codr-shiv/amr/learning/iteration-phase/frames_2026-09-26_03.27.23.pdf

view_frames Result

Recorded at time: 1790373443.6042182

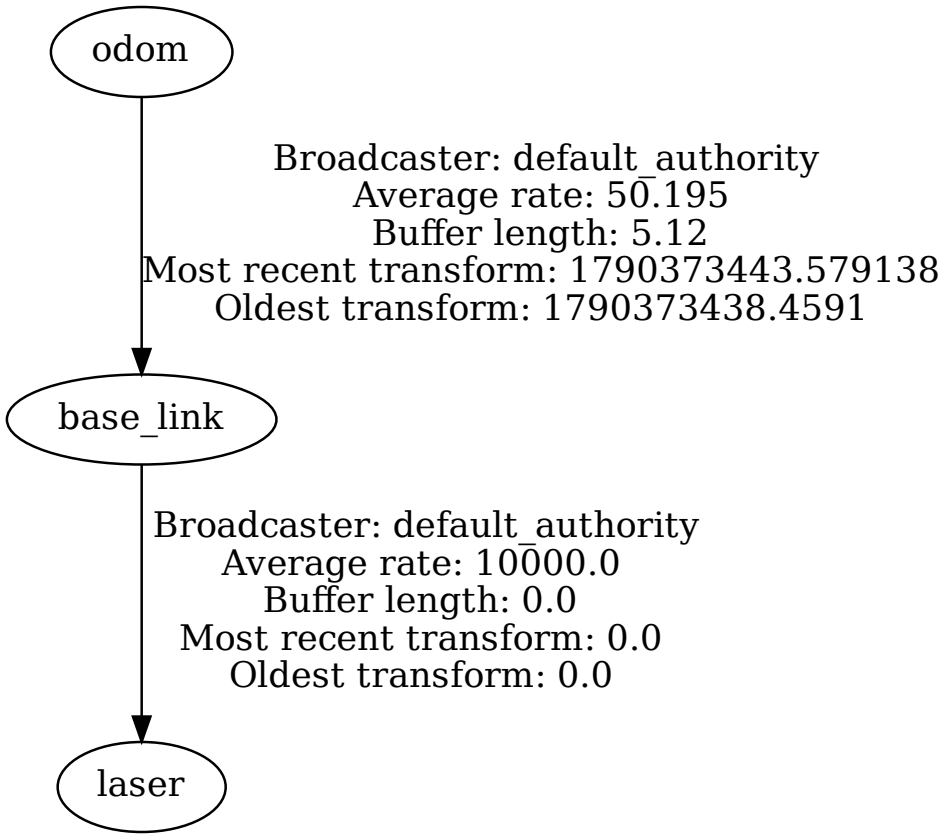
[picture p2: figure]
odom; base_link; Broadcaster: default_authority Average rate: 50.195 Buffer length: 5.12 Most recent transform: 1790373443.579138 Oldest transform: 1790373438.4591; laser; Broadcaster: default_authority Average rate: 10000.0 Buffer length: 0.0 Most recent transform: 0.0 Oldest transform: 0.0
