codr-shiv/amr/learning/iteration-phase/frames_2026-09-26_08.47.51.pdf

view_frames Result

Recorded at time: 1790392671.2278192

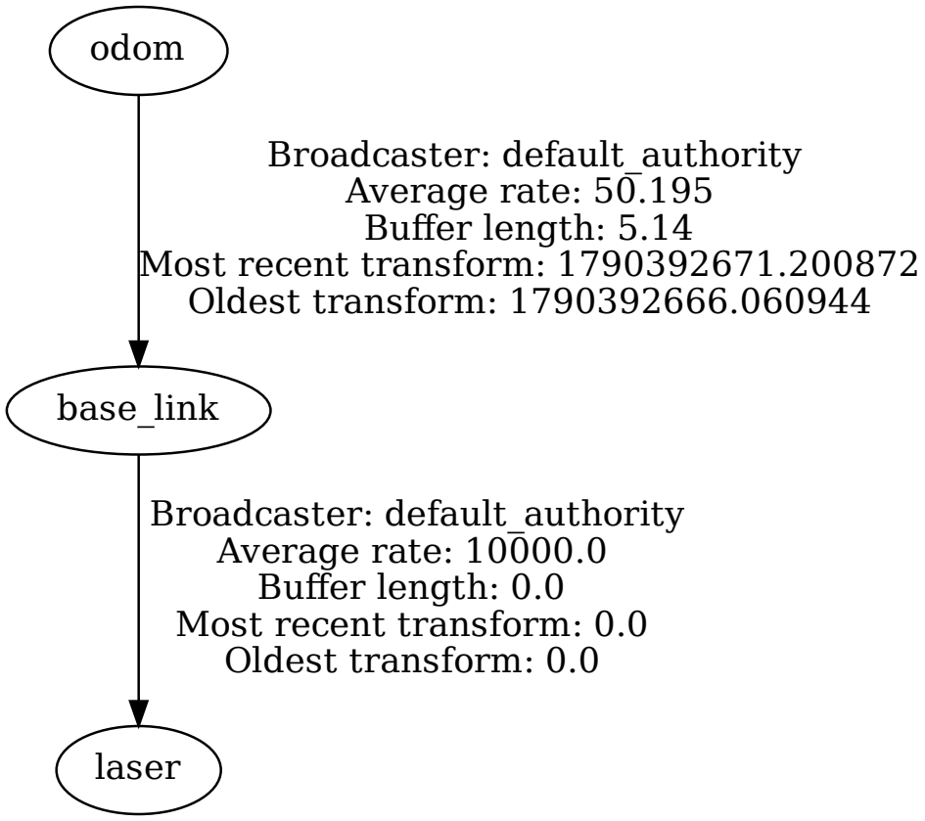
[picture p3: figure]
odom; base_link; Broadcaster: default_authority Average rate: 50.195 Buffer length: 5.14 Most recent transform: 1790392671.200872 Oldest transform: 1790392666.060944; laser; Broadcaster: default_authority Average rate: 10000.0 Buffer length: 0.0 Most recent transform: 0.0 Oldest transform: 0.0
