codr-shiv/amr/learning/iteration-phase/frames_2026-09-26_07.19.03.pdf

view_frames Result

Recorded at time: 1790387343.1438324

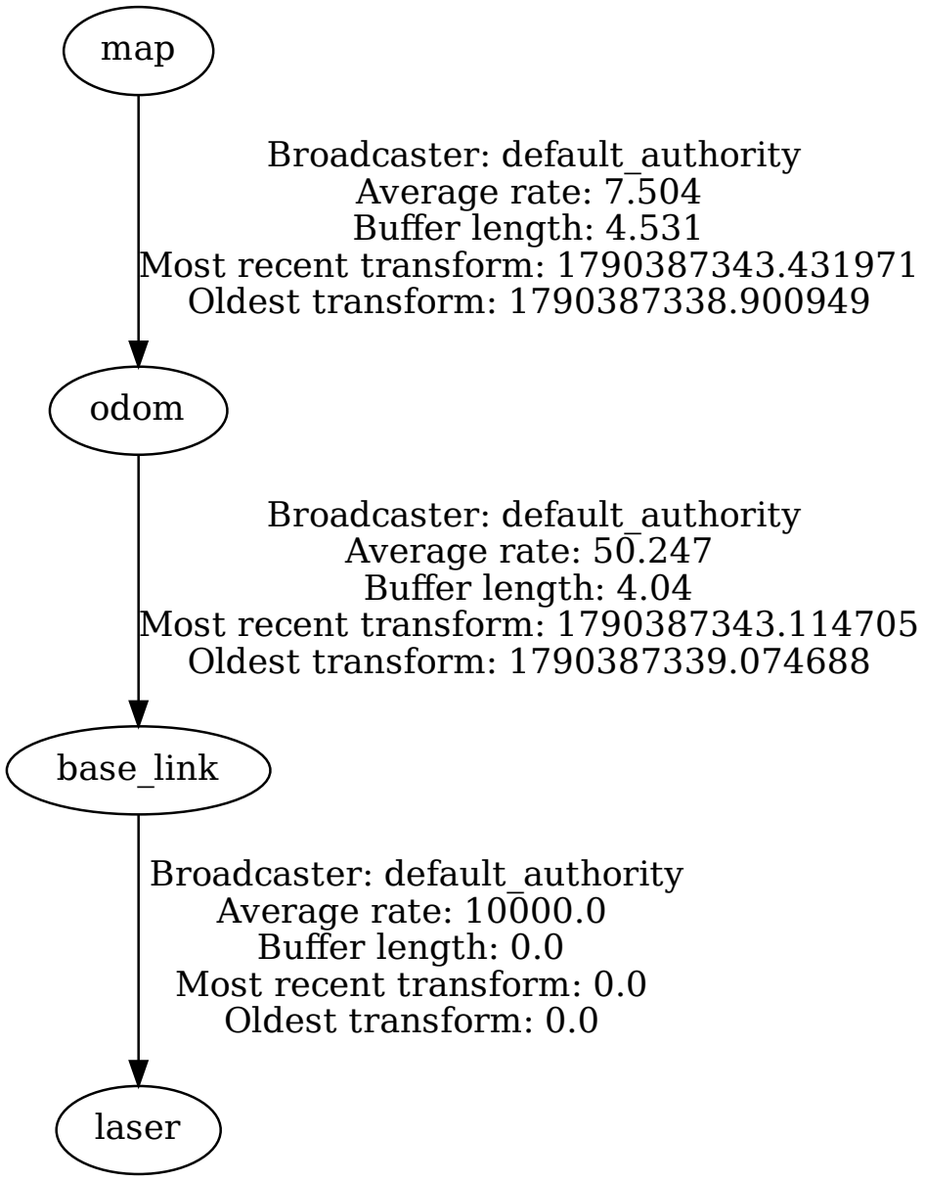
[picture p4: figure]
map; odom; Broadcaster: default_authority Average rate: 7.504 Buffer length: 4.531 Most recent transform: 1790387343.431971 Oldest transform: 1790387338.900949; base_link; Broadcaster: default_authority Average rate: 50.247 Buffer length: 4.04 Most recent transform: 1790387343.114705 Oldest transform: 1790387339.074688; laser; Broadcaster: default_authority Average rate: 10000.0 Buffer length: 0.0 Most recent transform: 0.0 Oldest transform: 0.0
