codr-shiv/amr/final-product/docs/guides/02-micro-ros-communication.md

# micro-ROS communication (ESP32 ⇄ Raspberry Pi)

How the ESP32 becomes part of the ROS 2 graph: transport, the agent, entities, QoS, message memory,
time synchronization, reconnection, and how to debug it.

Code: [`firmware/esp32/firmware/amr_esp32_wifi/amr_esp32_wifi.ino`](../../firmware/esp32/firmware/amr_esp32_wifi/amr_esp32_wifi.ino) (micro-ROS layer),
[`microros_ws/`](../../microros_ws/) (agent), [`amr_bringup.sh`](../../amr_bringup.sh) (starts the agent),
[`scripts/build.sh`](../../scripts/build.sh) (builds it).

> The ESP32 hardware team's own documentation in [`firmware/esp32/`](../../firmware/esp32/README.md) (README + `docs/01–05`) is the authoritative source for the ESP32 side; this guide explains how it fits the rest of the stack.

---

## 1. Why micro-ROS and how it works

A microcontroller can't run a full DDS stack. micro-ROS splits the work:

```mermaid
flowchart LR
    subgraph ESP32
        APP["firmware<br/>rclc API"] --> RMW["rmw_microxrcedds"] --> XC["Micro XRCE-DDS client"]
    end
    subgraph Pi["Raspberry Pi"]
        AG["micro_ros_agent<br/>(Micro XRCE-DDS agent + Fast DDS)"]
        ROS["ROS 2 nodes<br/>(amr_diff_drive, ...)"]
    end
    XC <-->|"XRCE-DDS protocol<br/>UDP over Wi-Fi, port 8888"| AG
    AG <-->|"DDS (RTPS)"| ROS
```

- The **client** (on the ESP32) sends small XRCE requests: "create a participant", "create a topic", "write this sample".
- The **agent** (on the Pi) creates the real DDS entities *on the ESP32's behalf* and forwards data both ways.
  To every other ROS 2 node, the ESP32's publishers and subscribers look like normal ROS 2 endpoints.
- If the agent isn't running, the ESP32 has no connection to ROS at all.

## 2. The agent (Pi side)

| Item | Value |
|---|---|
| Package | `micro_ros_agent` 3.0.6 (in `microros_ws/src/uros/micro-ROS-Agent/`), plus `micro_ros_msgs` |
| Built by | `scripts/build.sh agent`: `colcon build --packages-select micro_ros_setup`, then `ros2 run micro_ros_setup build_agent.sh`, which runs `colcon build --packages-up-to micro_ros_agent --cmake-args -DUAGENT_BUILD_EXECUTABLE=OFF -DUAGENT_P2P_PROFILE=OFF` |
| Superbuild | The agent's CMake downloads and builds eProsima **Micro-XRCE-DDS-Agent v2.4.2** (needs internet on the first build) |
| Started by | `amr_bringup.sh` step 1: `ros2 run micro_ros_agent micro_ros_agent udp4 --port 8888`, log `~/amr_logs/agent.log` |
| Transport | UDP over IPv4, listening on port 8888 on all interfaces |
| Readiness check | the bringup waits up to 60 s for a message on `/encoder_telemetry` |

Other agent options (not used here): `-v6` (verbose log, shows every message), `serial --dev /dev/ttyUSB0 -b 115200` for a wired link.

The agent keeps one "graph manager" per DDS domain: **the domain of the ESP32's entities is chosen by the ESP32**,
not by the agent's `ROS_DOMAIN_ID` (see §8).

## 3. Transport setup (ESP32 side)

The sketch does `#include "secrets.h"`. Copy `secrets.example.h` to `secrets.h` (same folder, ignored by git) and fill it in:

```cpp
#define SSID_NAME       "your-wifi-name"
#define SSID_PASSWORD   "your-wifi-password"
#define AGENT_IP        "192.168.0.xxx"     // Raspberry Pi IP (where the micro-ROS agent runs)
#define AGENT_PORT      8888                // micro-ROS agent UDP port
```

The Pi needs a **static IP** (or a DHCP reservation on the router) so `AGENT_IP` stays valid; check it with
`hostname -I`. A wired alternative, `firmware/amr_esp32_serial/` (agent: `serial --dev /dev/ttyUSB0 -b 115200`), exists
but **hasn't been run on the real hardware** yet. If you use it, note that the RPLIDAR is also on `/dev/ttyUSB0`: give
the ESP32 its own device name (`/dev/serial/by-id/...`) in the agent command, and change `amr_bringup.sh` step 1 to the
serial agent ([`docs/03_microros_interface.md` §7](../../firmware/esp32/docs/03_microros_interface.md)).

In `setup()`:
1. `WiFi.begin(SSID_NAME, SSID_PASSWORD)` and wait until connected (prints the ESP32's IP).
2. `set_microros_wifi_transports(SSID, PASSWORD, AGENT_IP, AGENT_PORT)`: registers micro_ros_arduino's UDP
   transport so every XRCE packet goes to `AGENT_IP:8888`.
3. `WiFi.setSleep(false)`: disables Wi-Fi modem sleep. With sleep on, the radio naps between beacons and UDP latency
   jumps to tens or hundreds of ms.
4. `initTelemetryMsg()`, then `agentState = WAITING_AGENT`. The micro-ROS entities are created later by the state machine (§5).

The control task is started **before** Wi-Fi, so the motors are held at zero while the network comes up.

## 4. Entities, topics and QoS

| Entity | Name | Type | QoS | Created with |
|---|---|---|---|---|
| Node | `esp32_wifi_wheel_node` (no namespace) | | | `rclc_node_init_default` |
| Subscription | `left_vel` → `/left_vel` | `std_msgs/msg/Float64` | reliable, keep last (default) | `rclc_subscription_init_default` |
| Subscription | `right_vel` → `/right_vel` | `std_msgs/msg/Float64` | reliable, keep last (default) | `rclc_subscription_init_default` |
| Publisher | `encoder_telemetry` → `/encoder_telemetry` | `sensor_msgs/msg/JointState` | **best effort** | `rclc_publisher_init_best_effort` |
| Executor | 2 handles (one per subscription), `ON_NEW_DATA` | | | `rclc_executor_init(..., 2, ...)` |

QoS compatibility with the Pi side:
- `amr_diff_drive` publishes `/left_vel` and `/right_vel` **reliable** (depth 10) → matches the reliable subscriptions.
- `amr_diff_drive` subscribes to `/encoder_telemetry` with `qos_profile_sensor_data` (**best effort**) → matches the
  best-effort publisher. (A reliable subscriber would *not* receive from a best-effort publisher.)
- `ros2 topic echo /encoder_telemetry` works; if you write your own subscriber, use best effort.

The executor has exactly as many handles as subscriptions. Adding a subscription or timer without increasing that
number makes `rclc_executor_add_*` fail, `createEntities()` returns false, and the ESP32 never connects.

### Message memory (no heap)

micro-ROS messages with sequences need their buffers allocated by the application. The firmware uses static storage:

```cpp
char nameLeft[] = "left_wheel";  char nameRight[] = "right_wheel";  char frameId[] = "";
rosidl_runtime_c__String jointNames[2];   double jointPos[2];   double jointVel[2];
```

`initTelemetryMsg()` points `msg_encoder.name/position/velocity` at these arrays with `size = capacity = 2`,
`effort` empty, `header.frame_id` empty. Each publish only overwrites the numbers and the stamp.

### Callbacks

`left_vel_callback` / `right_vel_callback`: reject non-finite or |value| ≥ 1e6 (`isValid`), then store the value and
the `millis()` arrival time into the shared struct under the spinlock. They never touch the motors directly; the
50 Hz control task picks the values up (see [03-esp32-motor-control.md](03-esp32-motor-control.md)).

## 5. Connection state machine (`microRosStep()`, called from `loop()`)

```mermaid
stateDiagram-v2
    [*] --> WAITING_AGENT
    WAITING_AGENT --> AGENT_AVAILABLE: rmw_uros_ping_agent(100 ms, 1 try) ok, tried every 500 ms
    AGENT_AVAILABLE --> AGENT_CONNECTED: createEntities() ok → setAgentConnected(true)
    AGENT_AVAILABLE --> WAITING_AGENT: createEntities() failed → destroyEntities()
    AGENT_CONNECTED --> AGENT_CONNECTED: spin_some(1 ms); publish telemetry every 50 ms
    AGENT_CONNECTED --> AGENT_DISCONNECTED: rmw_uros_ping_agent(100 ms, 3 tries) failed (checked every 1 s)
    AGENT_DISCONNECTED --> WAITING_AGENT: setAgentConnected(false) (targets cleared), destroyEntities()
```

- **createEntities():** default allocator → `rclc_support_init` → node → 2 subscriptions → best-effort publisher →
  executor + 2 subscriptions → `syncClock()` (time sync, §6; a failed sync isn't fatal and is retried). Any other failure returns false.
- **destroyEntities():** sets the session-destroy timeout to 0 (so it doesn't block waiting for a dead agent),
  then finalizes publisher, subscriptions, executor, node, support.
- **setAgentConnected(false)** also zeroes the stored ROS targets, so the robot never resumes an old command after a reconnect.
- While connected, the control task only uses ROS targets that are fresh (≤ 500 ms old). While not connected, it forces zero.

Serial messages: `# micro-ROS: CONNECTED to agent`, `# micro-ROS: agent LOST - motors stopped, retrying...`.

## 6. Time synchronization and telemetry stamps

`amr_diff_drive` uses the telemetry stamp to know *when* a sample was measured (latency compensation), so the stamp
must be on the **Pi's clock**.

On this board `rmw_uros_epoch_nanos()` only advances in **whole seconds** (`nanosec` never changes), so it can't be
used directly as a stamp. The firmware therefore measures a clock offset once and uses the ESP32's own 64-bit
microsecond timer:

1. **`syncClock()`** (on connect, then every `RESYNC_MS` = 60 s; every 5 s while never synced): up to 4 ×
   `rmw_uros_sync_session(100)`; each gives `offset = rmw_uros_epoch_nanos() − esp_timer_get_time()·1000`. Two consecutive
   offsets must agree within 20 ms (rejects a sync during which the 1 s clock ticked); the accepted offset is their mean.
   A failed sync keeps the previous offset.
2. **Sample time:** the control task records `sampleUs = esp_timer_get_time()` at the moment it reads the encoders.
3. **`publishTelemetry()`:** `stamp = sampleUs·1000 + clockOffsetNs` (Pi epoch time of the *encoder read*, µs resolution).
   Stamps are kept strictly increasing after small re-sync corrections; a jump > 1 s (e.g. the Pi's clock was reset) is
   accepted. If the clock never synced, the stamp is time since ESP32 boot, which `amr_diff_drive` rejects
   (offset > 0.5 s) and replaces with the receive time.

Notes:
- The 60 s re-sync cancels crystal drift, so `max_stamp_offset: 0.5` s on the Pi isn't exceeded in long sessions.
- Details: [`docs/03_microros_interface.md` §5](../../firmware/esp32/docs/03_microros_interface.md).
- The Pi's own clock should be NTP-synced (`chronyc tracking`); don't change the system time while running.
- Measured on the robot (28 Sep 2026 bringup log): encoder latency over 139 ten-second windows: means 15–242 ms (median 81 ms), single samples 4.6–410 ms, **0 stamps rejected**. Latency above the 0.2 s prediction limit isn't compensated.

## 7. Data flow and rates

| Direction | Topic | Rate | Produced by |
|---|---|---|---|
| Pi → ESP32 | `/left_vel`, `/right_vel` | 50 Hz, continuously (zeros when idle) | `amr_diff_drive` timer |
| ESP32 → Pi | `/encoder_telemetry` | 20 Hz (`PUB_INTERVAL_MS = 50`) | `publishTelemetry()` in `loop()` |

The ESP32 needs commands at ≥ 5 Hz (`CMD_TIMEOUT_MS = 500`); 50 Hz leaves a big margin for lost packets.

## 8. ROS domain ID (0)

`createEntities()` calls `rclc_support_init(&support, 0, NULL, &allocator)` with default init options, i.e. it does **not**
set a domain ID, so the ESP32's entities are created in **domain 0** (the micro-ROS default).
The agent creates them in whatever domain the client asks for, independent of the agent's own `ROS_DOMAIN_ID`.

So the **whole robot uses domain 0**: `amr_bringup.sh` exports `ROS_DOMAIN_ID=0` (and warns if your shell had another
value), and the README tells you to set `export ROS_DOMAIN_ID=0` on the Pi and the laptop. If a shell is on a different
domain, `ros2 topic list` there won't show `/encoder_telemetry` and the ESP32 won't see `/left_vel`. Check:

```bash
echo $ROS_DOMAIN_ID
ros2 topic list | grep encoder          # visible in your domain?
ROS_DOMAIN_ID=0 ros2 topic list | grep encoder   # or only in domain 0?
```

If you ever need another domain, the firmware must set it too (replace the `rclc_support_init` line):
```cpp
rcl_init_options_t init_options = rcl_get_zero_initialized_init_options();
if (rcl_init_options_init(&init_options, allocator) != RCL_RET_OK) return false;
if (rcl_init_options_set_domain_id(&init_options, <id>) != RCL_RET_OK) return false;
if (rclc_support_init_with_options(&support, 0, NULL, &init_options, &allocator) != RCL_RET_OK) return false;
```
and change `amr_bringup.sh` and both `~/.bashrc` files to the same value.

## 9. Observed link stability

In the bringup log of 28 Sep 2026 (`learning/iteration-phase/amr_logs/`), over 22 minutes the agent recorded
**203 sessions** (median 1.7 s between new sessions) and `amr_diff_drive` logged `Encoder telemetry stale` 387 times
(throttled to once per 2 s). So the ESP32 was dropping and re-establishing the connection very often in that run; each
drop stops the motors. The firmware version running then isn't recorded.

Things to check if it happens again (hypotheses, not confirmed causes):
- Wi-Fi signal/interference at the robot; 2.4 GHz channel congestion; the access point's power saving.
- Ping-based disconnect: 3 pings × 100 ms timeout fail on a latency spike → reconnect. Try `rmw_uros_ping_agent(200, 5)`.
- Reliable subscriptions at 2 × 50 Hz over a lossy link: retransmissions can back up the XRCE stream. Options: publish
  `/left_vel`/`/right_vel` at a lower rate (≥ 5 Hz is enough), or combine them into one message.
- Brown-outs when the motors draw current (ESP32 resets show the boot banner on serial).
- Run the agent with `-v6` and watch the ESP32 serial output for `agent LOST`.

## 10. Troubleshooting

| Symptom | Check |
|---|---|
| Serial stuck at `Wi-Fi connecting` | SSID/password, 2.4 GHz network |
| Serial stuck at `waiting for micro-ROS agent` | agent running? `AGENT_IP` = Pi's current IP (`hostname -I`)? same subnet? firewall on UDP 8888? |
| Agent log shows sessions but no `/encoder_telemetry` on the Pi | domain mismatch (§8); `ros2 daemon stop` and retry |
| `ros2 topic pub /left_vel ...` has no effect | ESP32 needs ≥ 5 Hz (`-r 10`); `amr_diff_drive` also publishes these topics |
| `Encoder stamp not used (stamp offset ...)` on the Pi | time sync failed; reconnect (restart the agent) and check `chronyc tracking` |
| `sudo apt update`: `Conflicting values set for option Signed-By ... packages.ros.org` | old ROS `.list` file with an inline key: `sudo rm -f /etc/apt/sources.list.d/ros*.list`, recreate `ros2.list` with `signed-by=/usr/share/keyrings/ros-archive-keyring.gpg`, `sudo apt update` |
| `ros2 topic pub` waits with `Waiting for at least 1 matching subscription(s)...` | agent not running (the ESP32 has no bridge); start it and keep it running. The firmware reconnects by itself |
| Build fails with `undefined reference to dds::xrce::...` | stale build: `rm -rf microros_ws/build microros_ws/install microros_ws/log` then `scripts/build.sh agent` |
