codr-shiv/amr/learning/iteration-phase/differential_drive/src/my_amr_control_pkg/urdf/amr_robot.urdf.xacro

<?xml version="1.0"?>
<robot xmlns:xacro="http://www.ros.org/wiki/xacro" name="amr_robot">
  <!-- Minimal Link Definitions -->
  <link name="base_link"/>
  <link name="left_wheel"/>
  <link name="right_wheel"/>

  <!-- Left Wheel Joint -->
  <joint name="left_wheel_joint" type="continuous">
    <parent link="base_link"/>
    <child link="left_wheel"/>
  </joint>

  <!-- Right Wheel Joint -->
  <joint name="right_wheel_joint" type="continuous">
    <parent link="base_link"/>
    <child link="right_wheel"/>
  </joint>

  <!-- ros2_control Hardware Mapping -->
  <ros2_control name="RealRobot" type="system">
    <hardware>
      <plugin>my_amr_control_pkg/MyAMRHardwareInterface</plugin>
    </hardware>
    <joint name="left_wheel_joint">
      <command_interface name="velocity"/>
      <state_interface name="position"/>
      <state_interface name="velocity"/>
    </joint>
    <joint name="right_wheel_joint">
      <command_interface name="velocity"/>
      <state_interface name="position"/>
      <state_interface name="velocity"/>
    </joint>
  </ros2_control>
</robot>
