codr-shiv/amr/learning/iteration-phase/differential_drive/src/my_amr_control_pkg/config/controllers.yaml

controller_manager:
  ros__parameters:
    update_rate: 50

    joint_state_broadcaster:
      type: joint_state_broadcaster/JointStateBroadcaster

    diff_drive_base_controller:
      type: diff_drive_controller/DiffDriveController

diff_drive_base_controller:
  ros__parameters:
    left_wheel_names: ["left_wheel_joint"]
    right_wheel_names: ["right_wheel_joint"]
    wheel_separation: 0.39
    wheel_radius: 0.056
    publish_rate: 50.0
    odom_frame_id: odom
    base_frame_id: base_link
    open_loop: false
    enable_odom_tf: true
    use_stamped_vel: false
    position_feedback: true
    pose_covariance_diagonal: [0.001, 0.001, 0.001, 0.001, 0.001, 0.01]
    twist_covariance_diagonal: [0.001, 0.001, 0.001, 0.001, 0.001, 0.01]
