codr-shiv/amr/final-product/firmware/esp32/firmware/amr_esp32_wifi/secrets.example.h

// Copy this file to "secrets.h" (same folder) and fill in your values.
// secrets.h is listed in .gitignore and must never be committed.
#pragma once

#define SSID_NAME       "your-wifi-name"
#define SSID_PASSWORD   "your-wifi-password"
#define AGENT_IP        "192.168.0.xxx"     // Raspberry Pi static IP (where the micro-ROS agent runs)
#define AGENT_PORT      8888                // micro-ROS agent UDP port
